kdsonone/asalz/Docs/#MT1750/Photos #MT1750/Measurement_Process.jpg

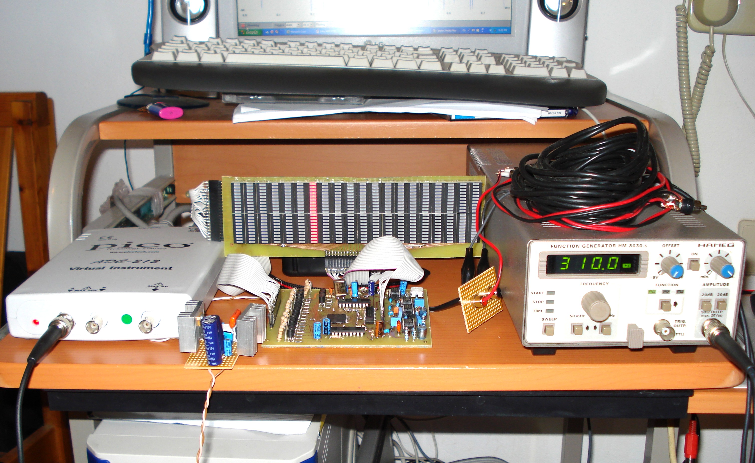
Docs/#MT1750/Photos #MT1750/Measurement_Process.jpg
