kdsonone/asalz/Docs/#MT1750/Photos #MT1750/Complete_Asssemply_photo.JPG

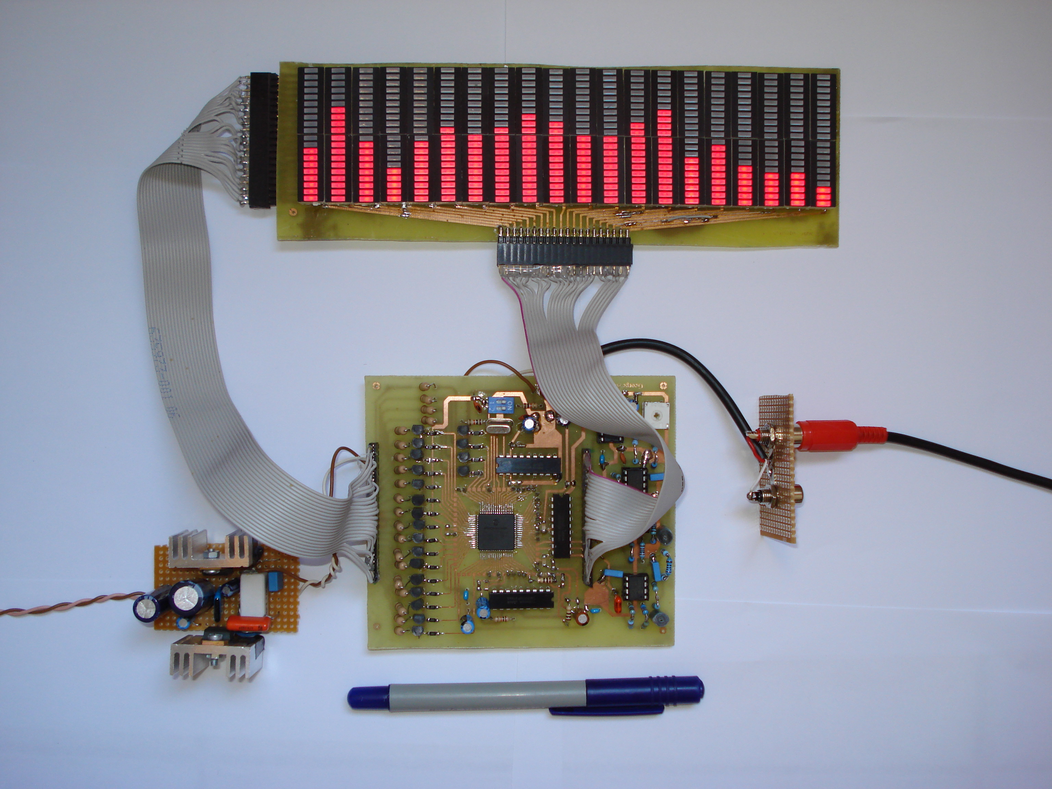
Docs/#MT1750/Photos #MT1750/Complete_Asssemply_photo.JPG
