kdsonone/asalz/Schematics/Project Outputs for AudioSpectrumAnalyzer/AudioSpectrum.TXT

M48
;Layer_Color=9474304
;FILE_FORMAT=2:5
INCH,LZ
;TYPE=PLATED
T1F00S00C0.02362
T2F00S00C0.02800
T3F00S00C0.03150
T4F00S00C0.03543
T5F00S00C0.03937
T6F00S00C0.04723
T7F00S00C0.04724
%
T01
X0258Y0337866
Y0346134
T02
X02095Y0277202
X02193Y02793
X02359Y02784
X02581Y02686
X02851Y02669
X02868Y02798
X02849Y02959
X02922Y02954
X02915Y0311
X03065Y03028
X031005Y027795
X02758Y02963
X02615Y03035
X02512Y02992
X02277Y03111
X02125Y03028
X0205Y03004
X02007Y03082
X0196Y03124
X02225Y031935
X02317Y03172
X02565Y03165
X02523Y03312
X02383Y0342
X0221Y03596
X0184Y0366
X0166
X017Y0398
X0165Y03233
X02769Y03322
X02822Y03144
X03011Y03157
X0294Y03455
X0328Y03365
X03374Y03348
T03
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
