kdsonone/asalz/Docs/#MT1750/Photos #MT1750/Complete_Assemply 2.JPG

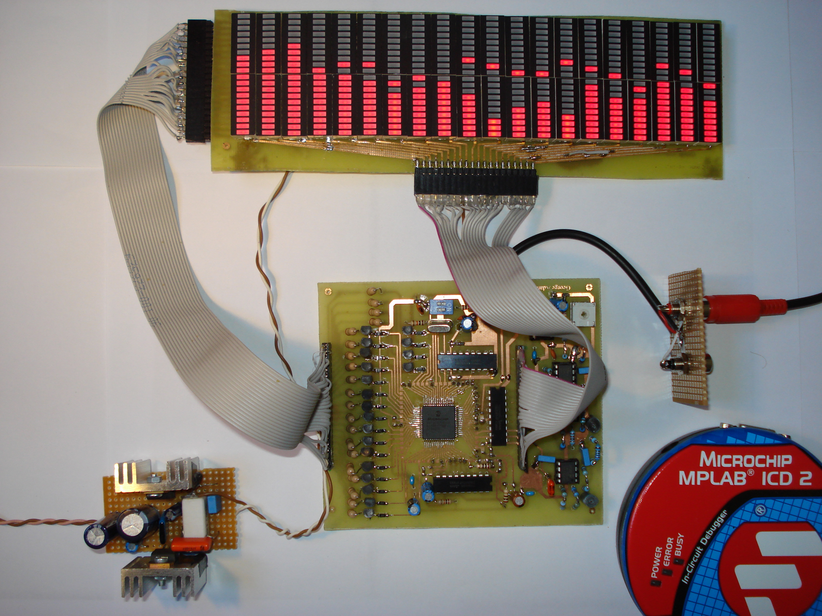
Docs/#MT1750/Photos #MT1750/Complete_Assemply 2.JPG
