kdsonone/asalz/Docs/#MT1750/Photos #MT1750/Complete_Asssemply_photo1.jpg

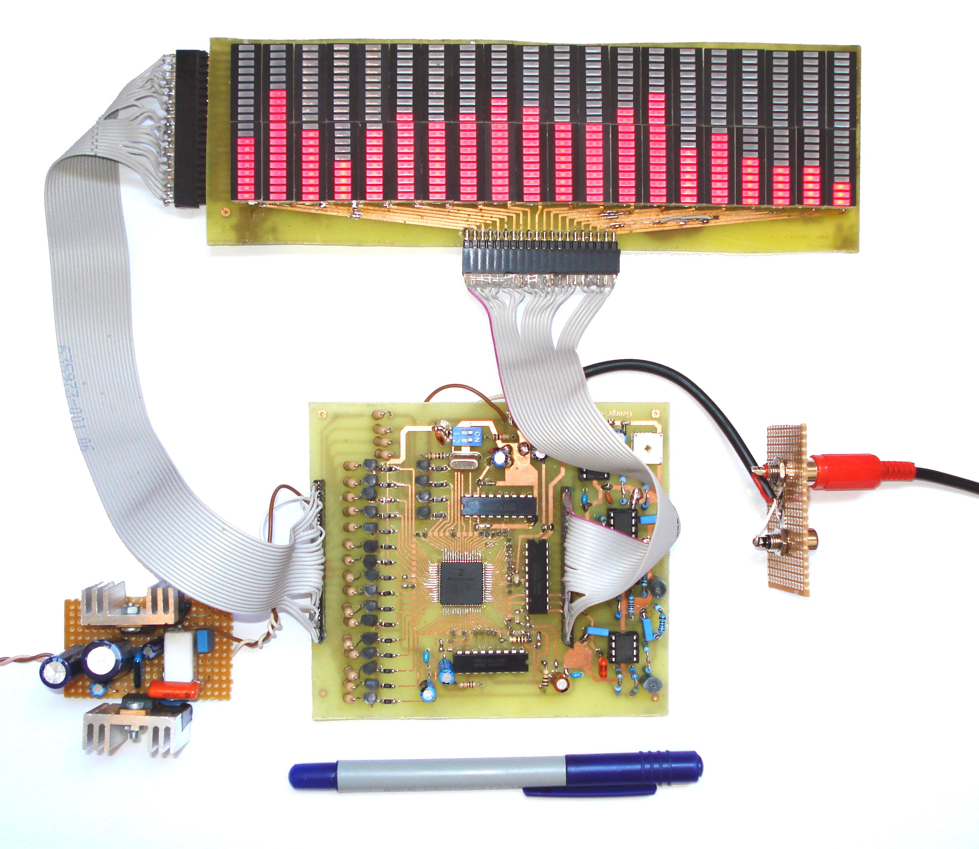
Docs/#MT1750/Photos #MT1750/Complete_Asssemply_photo1.jpg
