kdsonone/asalz/Docs/PIC32/LVC75Z779_Sch.pdf

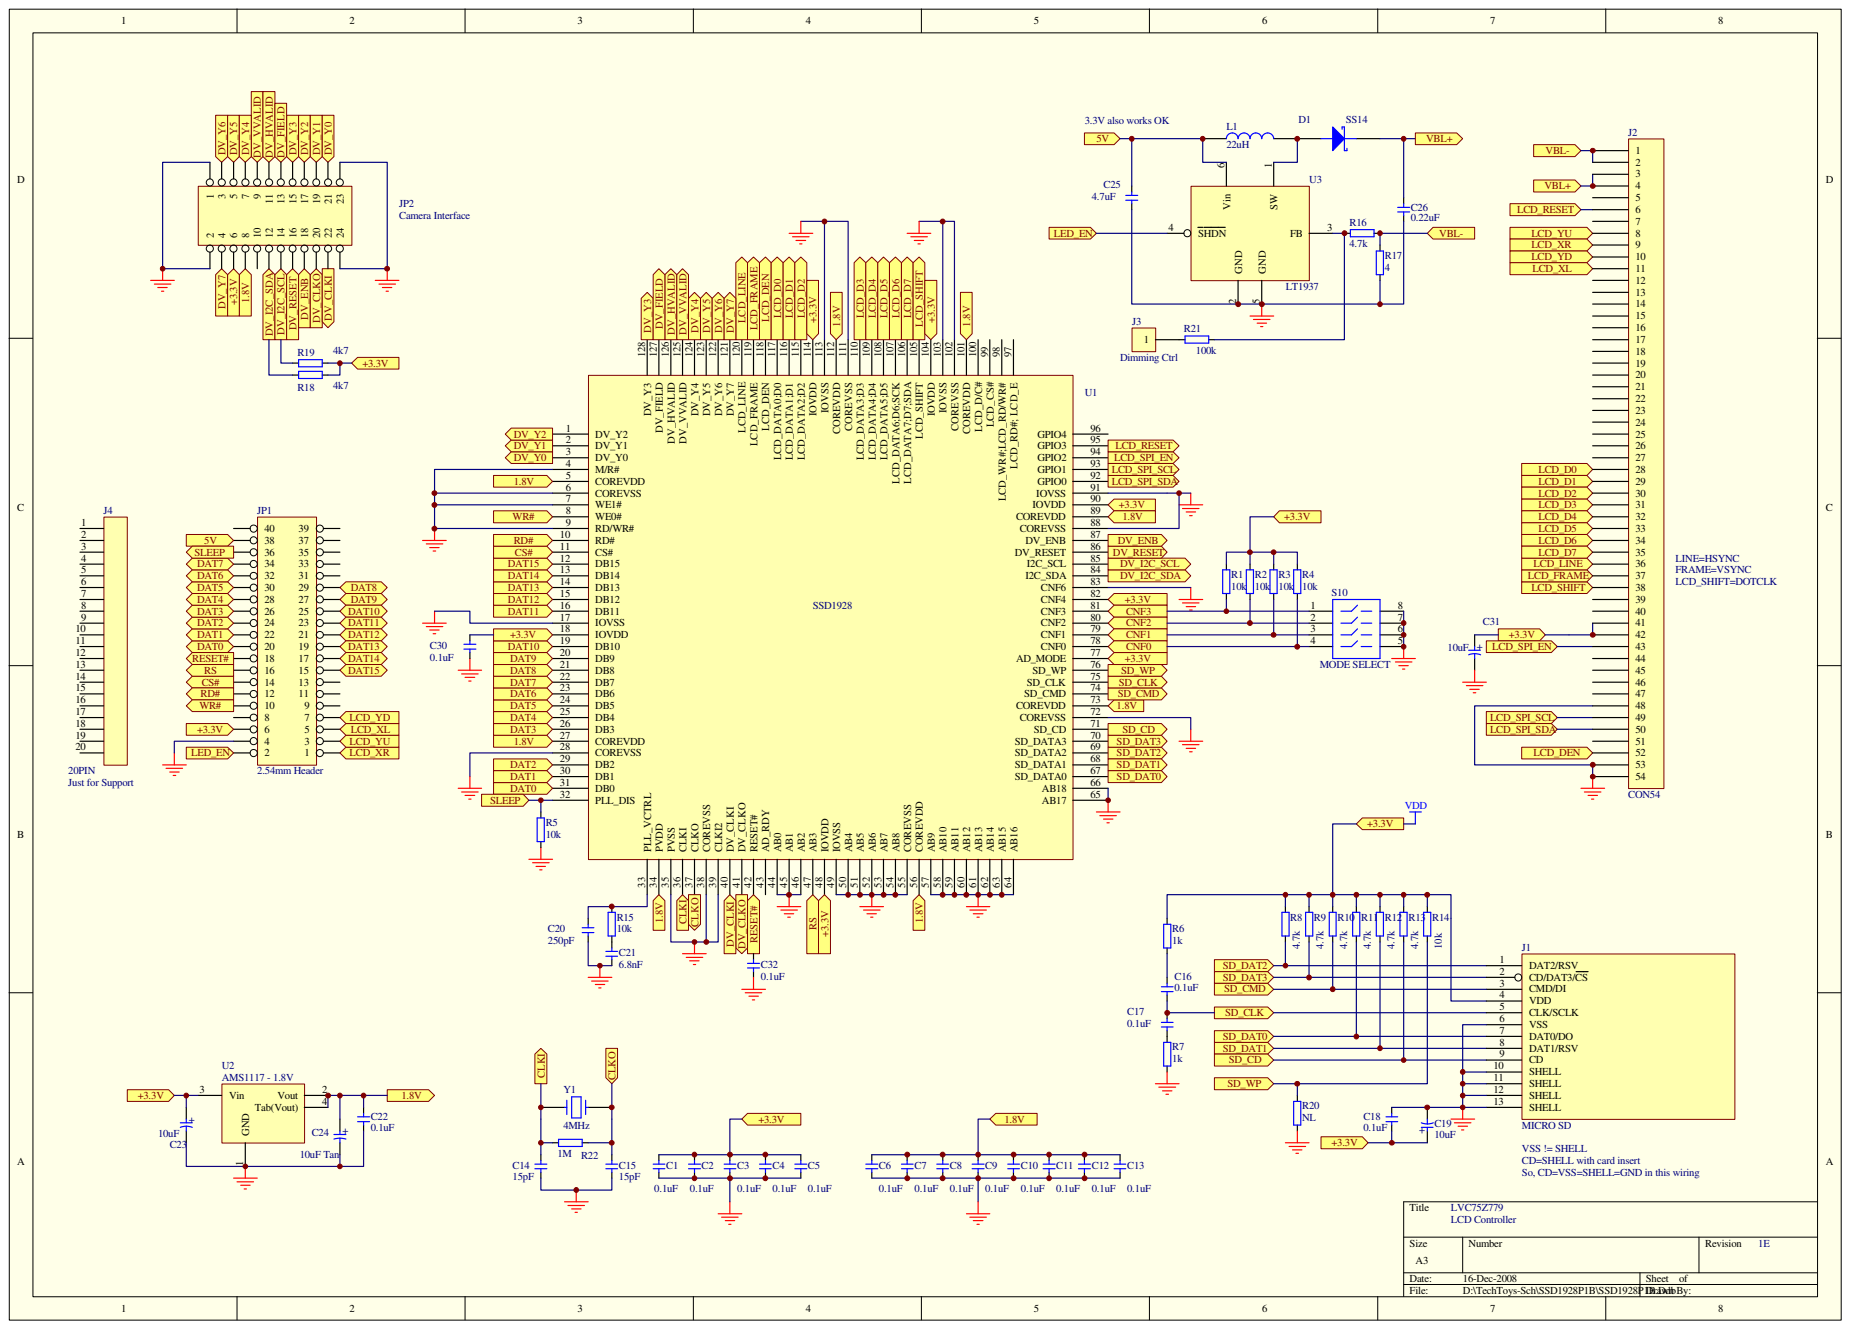
[picture p11: page 1]

VSS != SHELL
CD=SHELL with card insert
So, CD=VSS=SHELL=GND in this wiring
