kdsonone/asalz/(list of files, drawings)

Other design files:
Schematics/Audio.SchDoc
Schematics/AudioSpectrum.PcbDoc
Schematics/AudioSpectrumAnalyzer.PrjPcb
Schematics/History/AudioSpectrum.~(74).PcbDoc
Schematics/History/AudioSpectrum.~(78).PcbDoc
Schematics/History/AudioSpectrum.~(157).PcbDoc
